bazolting71-arch/Drone-Hook-Capability/cad/README.md

# CAD files

Add the Fusion archive and STEP of the full assembly here:

- `Drone_Payload_Hook_Assembly.f3d`: open in Autodesk Fusion. Includes the hook pivot joint (drag the hook 0 to 90 deg).
- `Drone_Payload_Hook_Assembly.step`: for any other CAD tool.
