bazolting71-arch/Drone-Hook-Capability/stl/3_Hook.stl

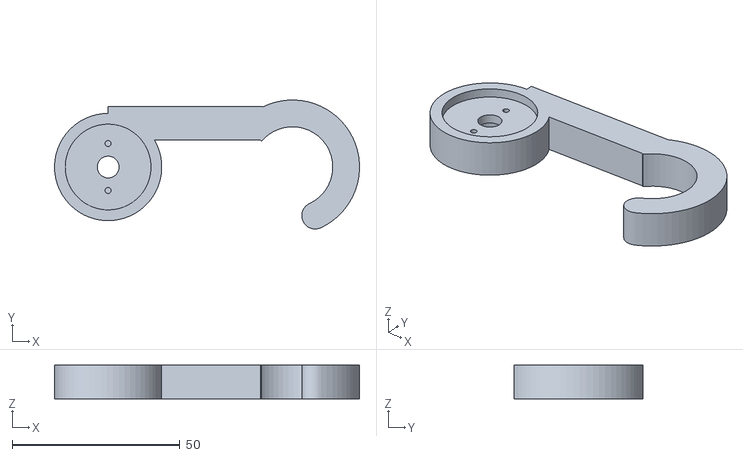
[picture p1: CAD file, 2026-10-28]
stl/3_Hook.stl
91.0 x 38.5 x 10.0
