bazolting71-arch/Drone-Hook-Capability/stl/9_Servo_Snap_Pin_print_x4.stl

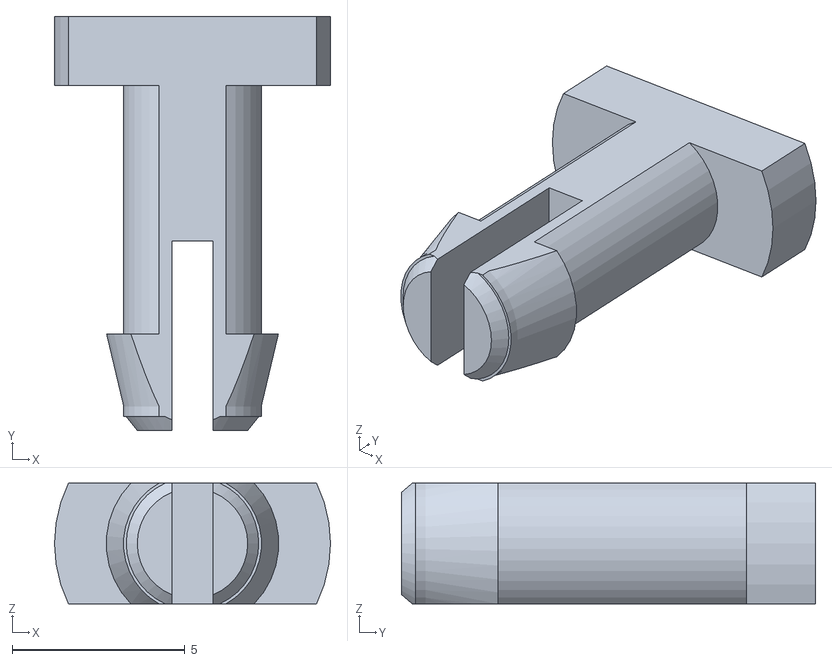
[picture p2: CAD file, 2026-10-28]
stl/9_Servo_Snap_Pin_print_x4.stl
8.00 x 12.0 x 3.50
