bazolting71-arch/Drone-Hook-Capability/stl/4_Pivot_Bushing_M12.stl

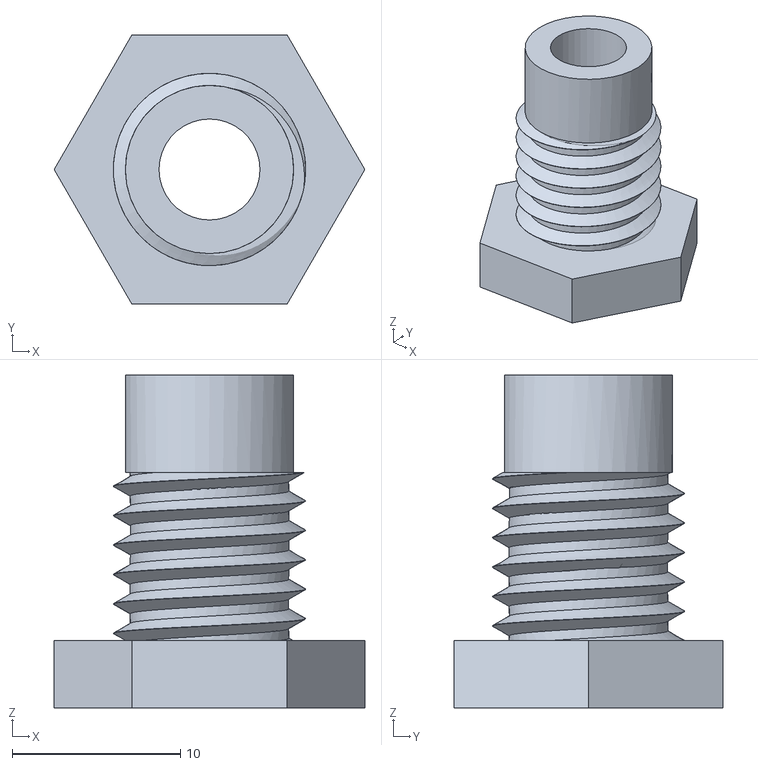
[picture p3: CAD file, 2026-10-28]
stl/4_Pivot_Bushing_M12.stl
18.5 x 16.0 x 19.8
