bazolting71-arch/Drone-Hook-Capability/stl/1_Mount_Plate.stl

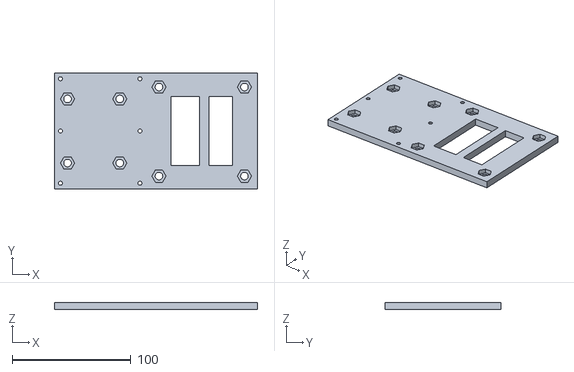
[picture p4: CAD file, 2026-10-28]
stl/1_Mount_Plate.stl
171.0 x 98.0 x 6.00
