bazolting71-arch/Drone-Hook-Capability/stl/2_Housing.stl

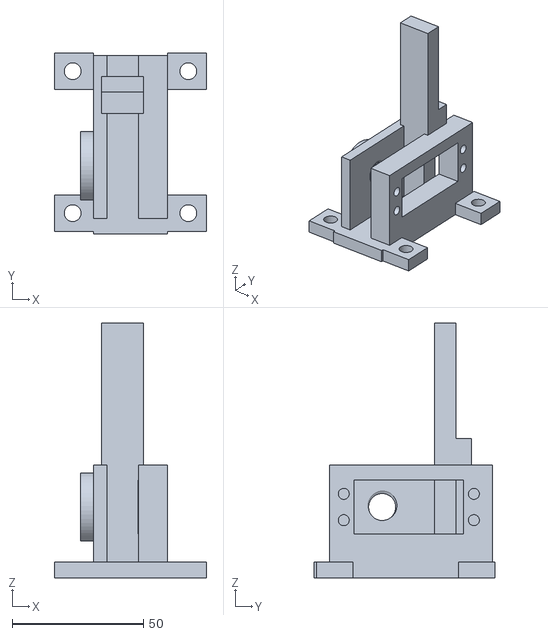
[picture p5: CAD file, 2026-10-28]
stl/2_Housing.stl
58.0 x 69.0 x 97.0
