bazolting71-arch/Drone-Hook-Capability/stl/6_Electronics_Lid_Board_Tray.stl

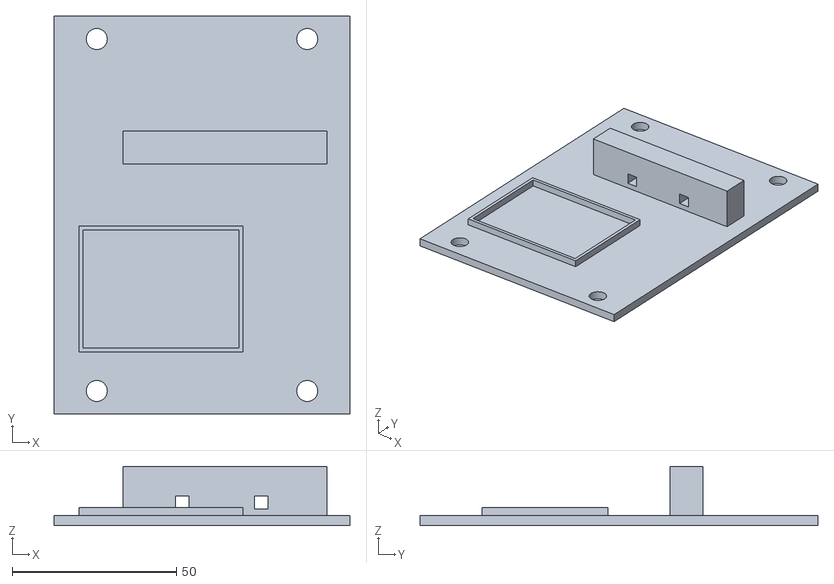
[picture p6: CAD file, 2026-10-28]
stl/6_Electronics_Lid_Board_Tray.stl
90.0 x 121.0 x 18.0
