bazolting71-arch/Drone-Hook-Capability/stl/5_Electronics_Box.stl

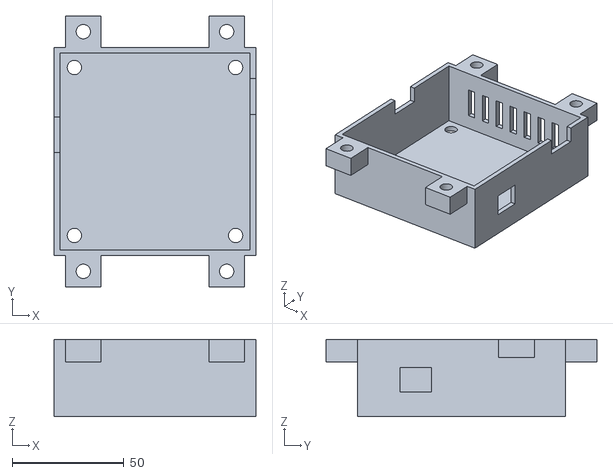
[picture p7: CAD file, 2026-10-28]
stl/5_Electronics_Box.stl
90.0 x 121.0 x 34.5
