bazolting71-arch/Drone-Hook-Capability/stl/8_M6_Nut_print_x12.stl

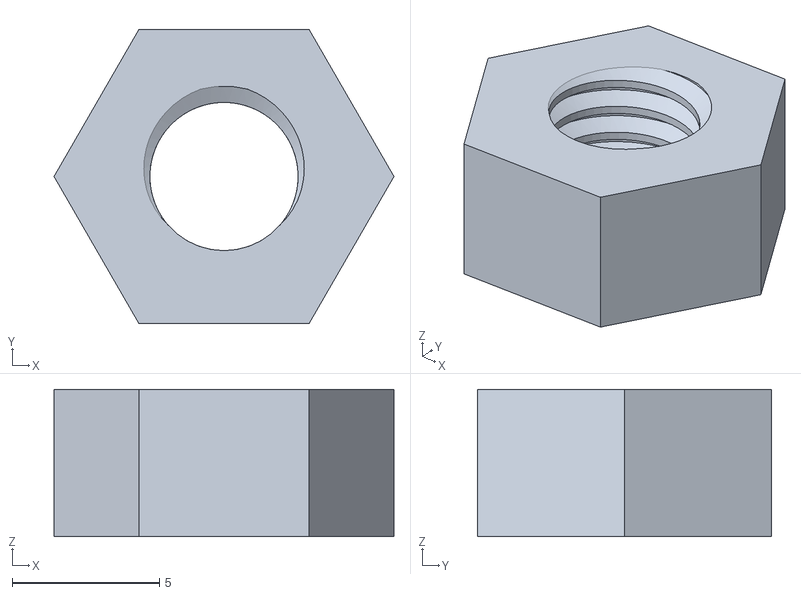
[picture p8: CAD file, 2026-10-28]
stl/8_M6_Nut_print_x12.stl
11.5 x 10.0 x 5.00
