bazolting71-arch/Drone-Hook-Capability/stl/7_M6x16_Bolt_print_x12.stl

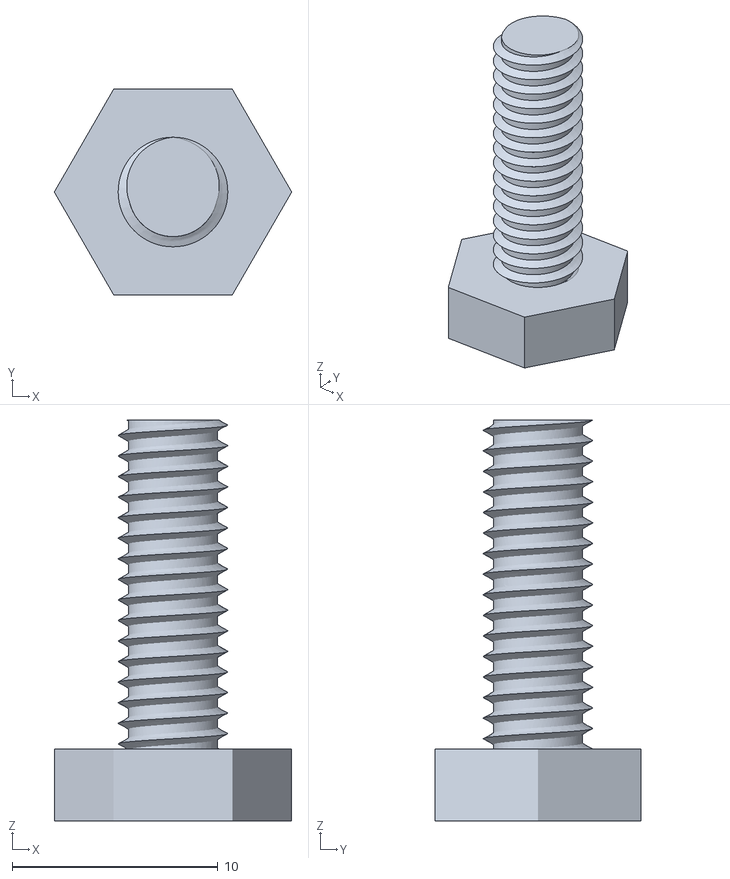
[picture p9: CAD file, 2026-10-28]
stl/7_M6x16_Bolt_print_x12.stl
11.5 x 10.0 x 19.5
