bazolting71-arch/Drone-Hook-Capability/(commit log)

2026-10-28 Add payload hook parts, assembly guide and servo test sketch
    - stl/: 9 print-oriented parts (plate, housing, hook, M12 bushing,
    electronics box and lid, printed M6 bolt/nut, servo snap pin)
    - README: parts, print settings, hardware, assembly, wiring,
    pre-flight checks and troubleshooting
    - firmware/hook_test: 0 = closed, 90 = open test sketch
    - cad/: placeholder for the Fusion archive and STEP
    - Replace the uploaded zip with the unpacked stl/ folder
    Claude-Session: https://claude.ai/code/session_0199maMrsXr7iUA3Zs1GMoVY
    [1_Mount_Plate.stl, 2_Housing.stl, 3_Hook.stl, 4_Pivot_Bushing_M12.stl, 5_Electronics_Box.stl, 6_Electronics_Lid_Board_Tray.stl, 7_M6x16_Bolt_print_x12.stl, 8_M6_Nut_print_x12.stl]
2026-10-28 README: printed servo horn replaces the bought horn and M2 screws
    The hook now has two drive pegs that key into a printed horn, which
    press-fits onto the servo spline. Adds part 10 (10_Servo_Horn_print.stl)
    and updates parts to buy, tools, assembly steps and troubleshooting.
    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
